ctejada10/echotube/assets/media/bike.jpg

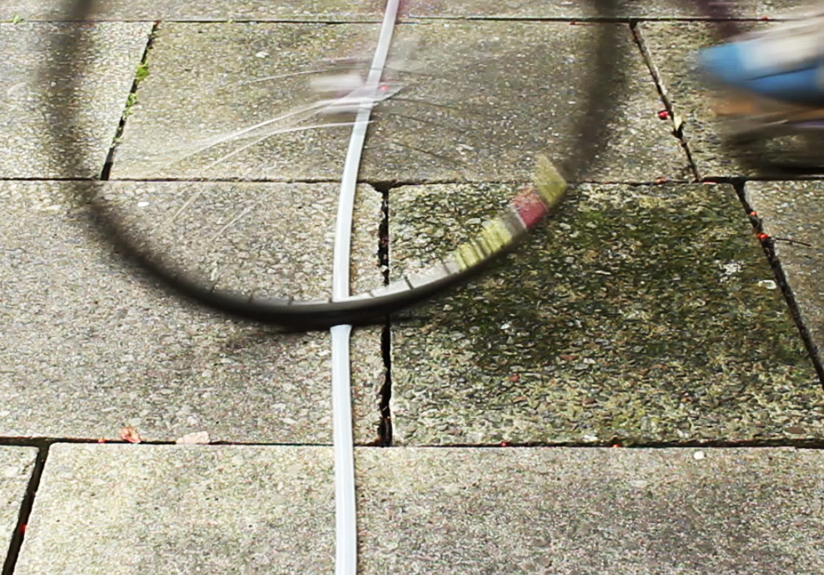
assets/media/bike.jpg
