ctejada10/echotube/assets/media/biketracker.jpg

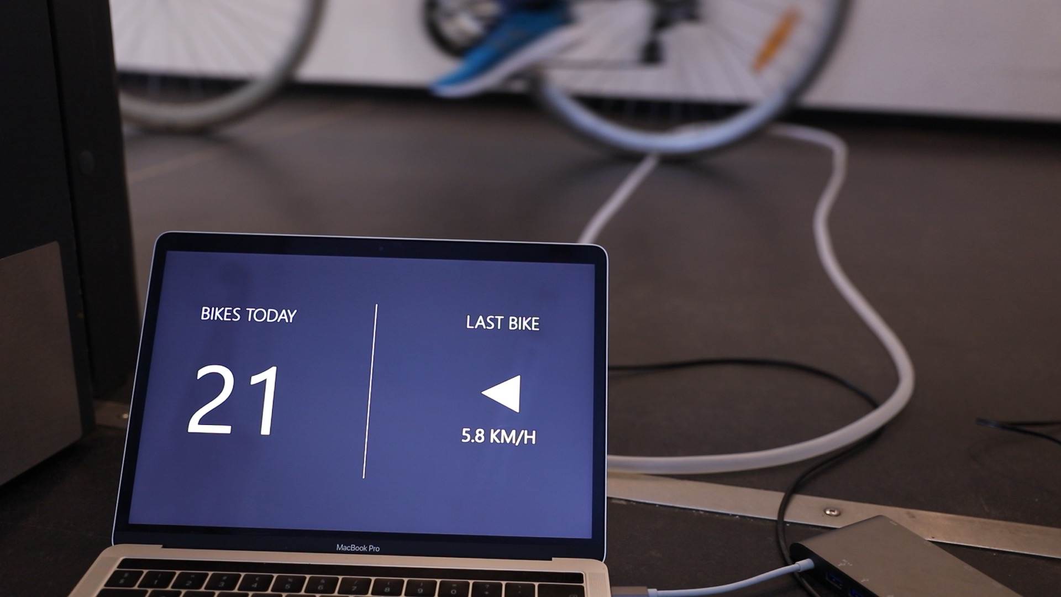
assets/media/biketracker.jpg
