ctejada10/echotube/assets/media/coupling.jpg

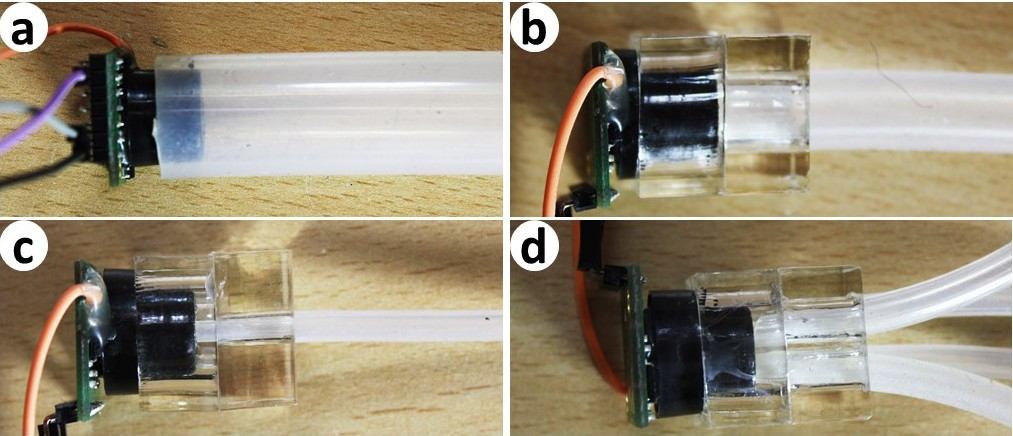
assets/media/coupling.jpg
