ctejada10/echotube/assets/media/dual_touch.png

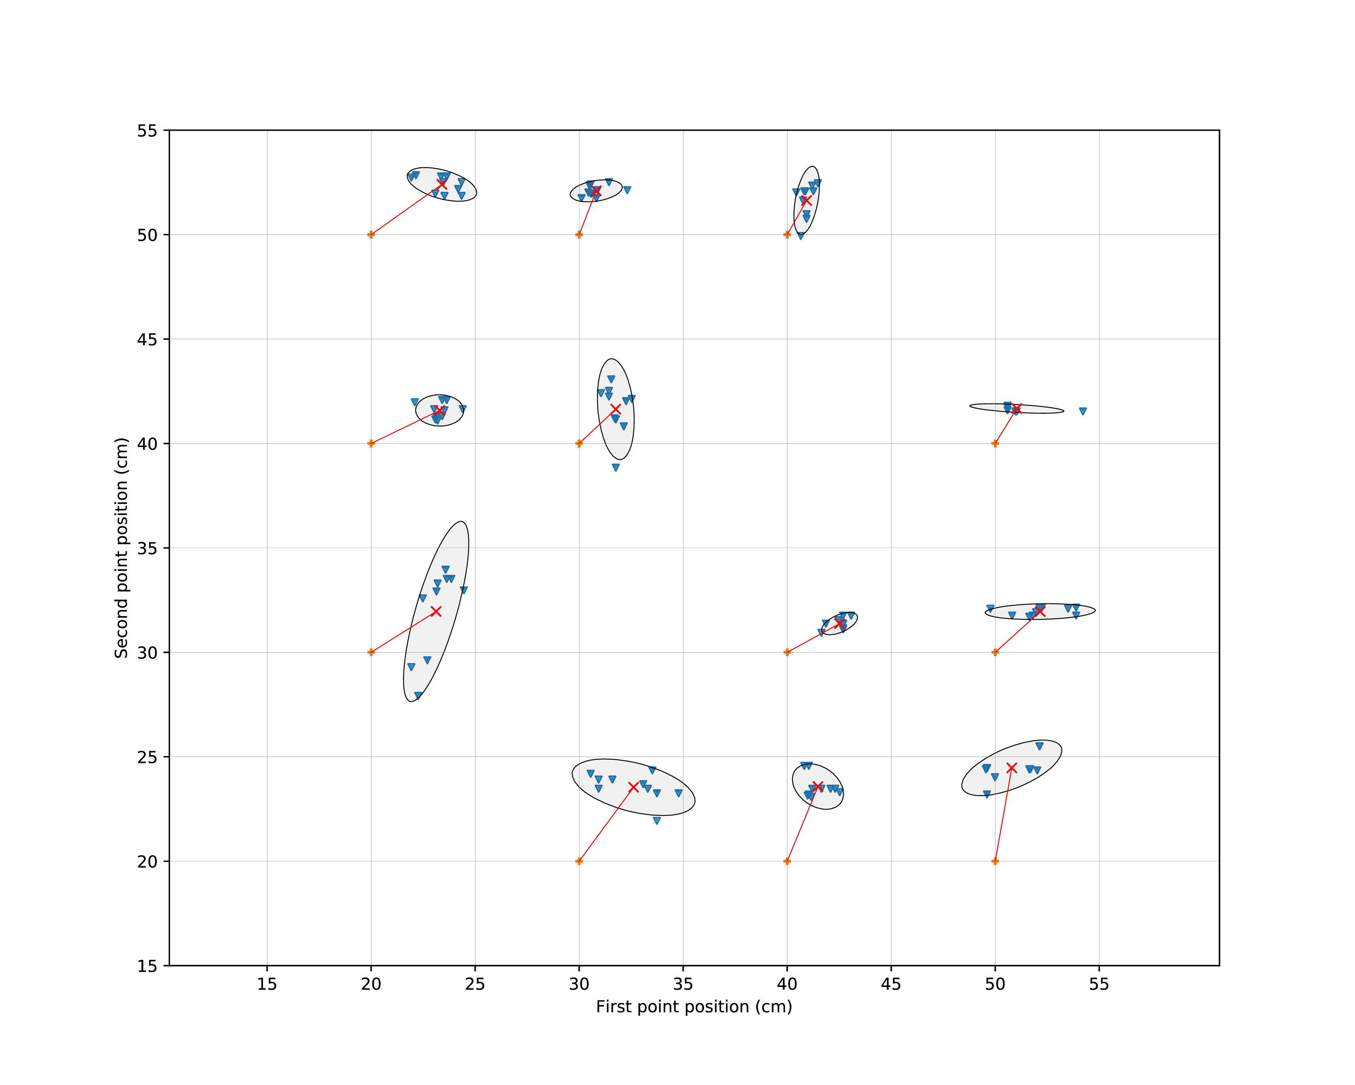
assets/media/dual_touch.png
