ctejada10/echotube/assets/media/error.png

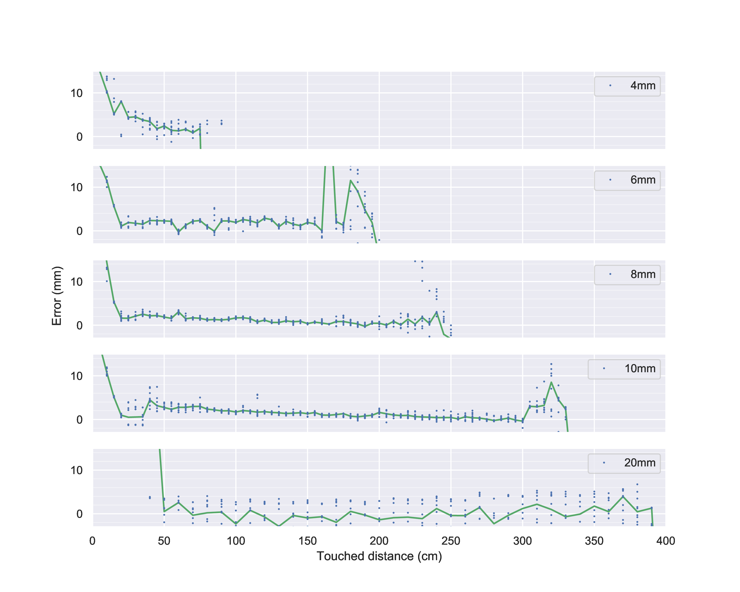
assets/media/error.png
