ctejada10/echotube/assets/media/glove.jpg

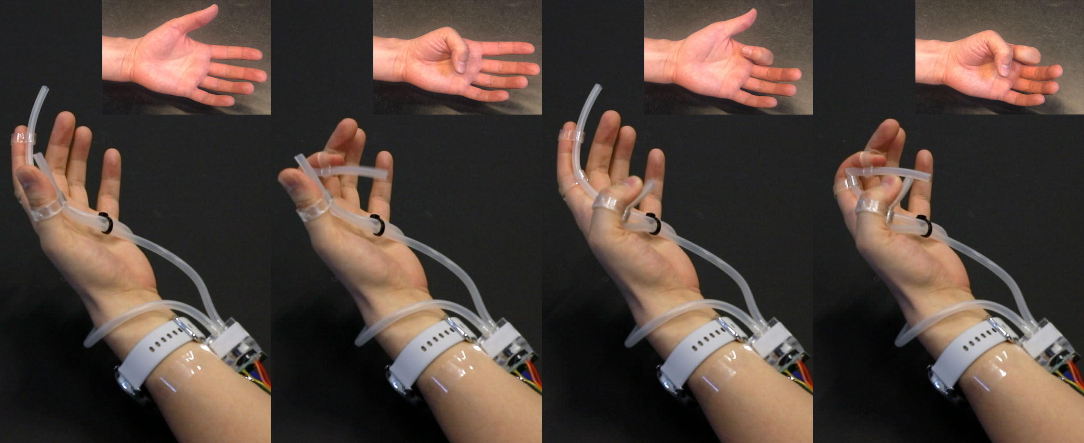
assets/media/glove.jpg
