ctejada10/echotube/assets/media/modular.jpg

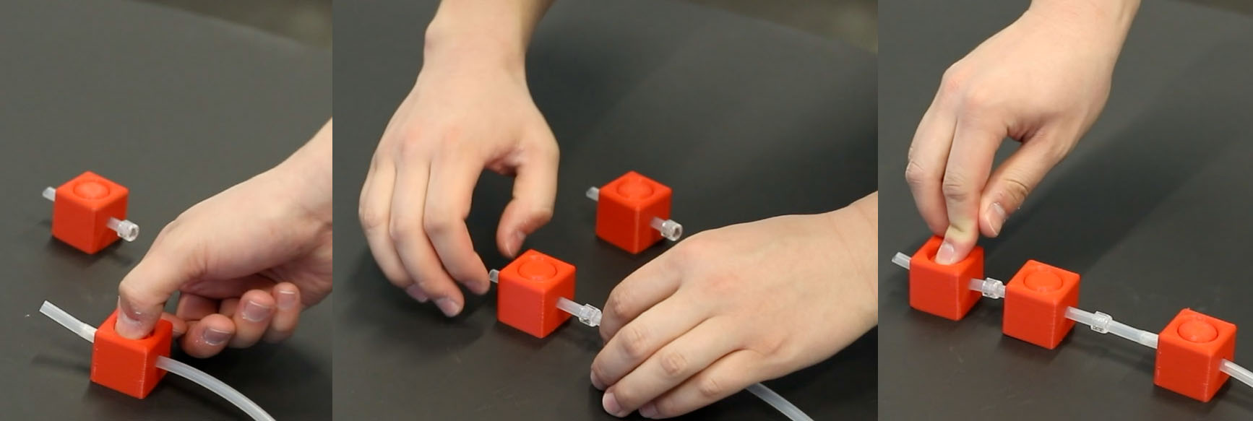
assets/media/modular.jpg
