ctejada10/echotube/assets/media/peak_detection.png

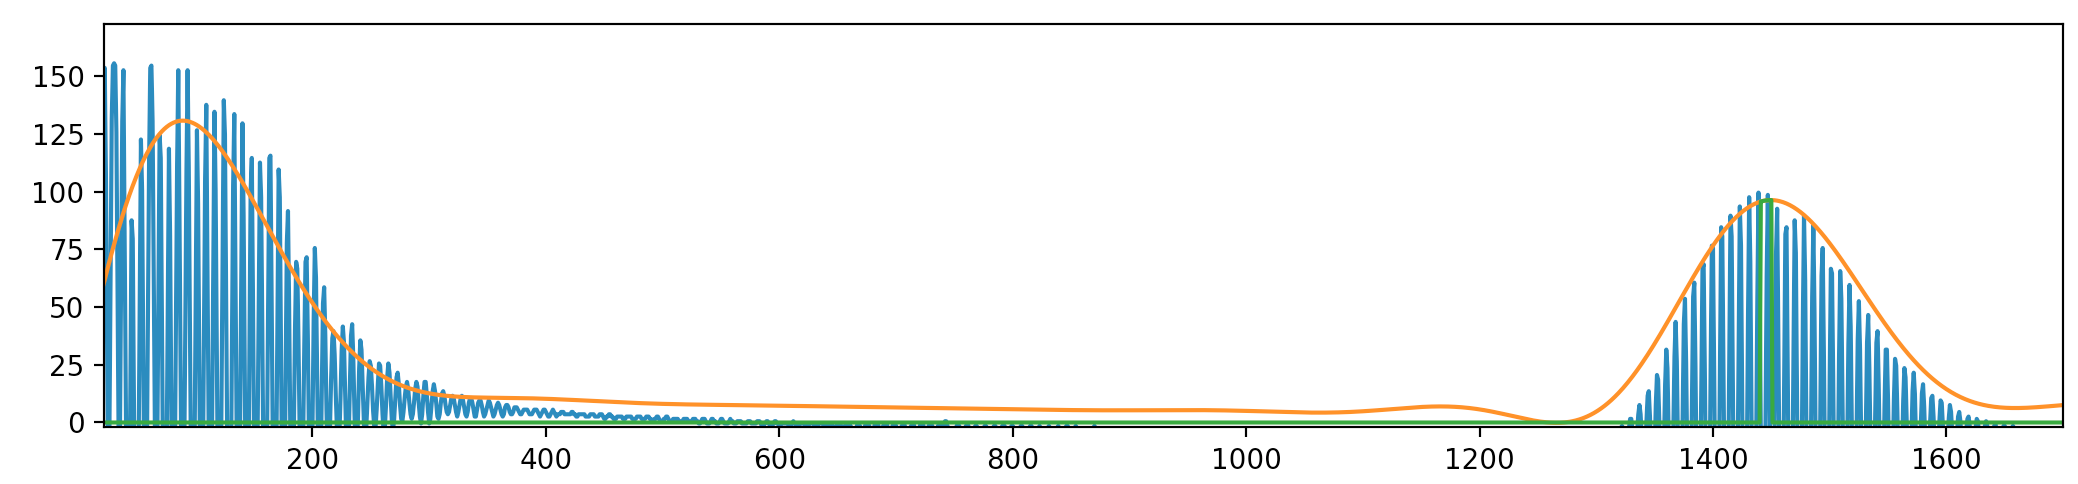
assets/media/peak_detection.png
