ctejada10/echotube/assets/media/sink.jpg

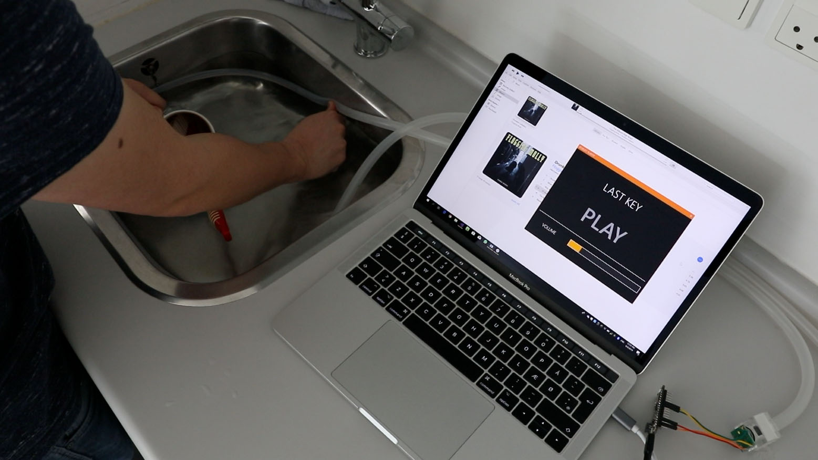
assets/media/sink.jpg
