ctejada10/echotube/assets/media/spiral_tube.jpg

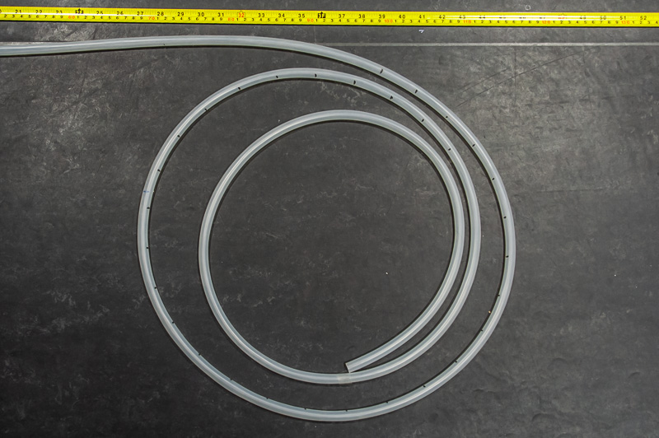
assets/media/spiral_tube.jpg
