ctejada10/echotube/assets/media/straight_curved.png

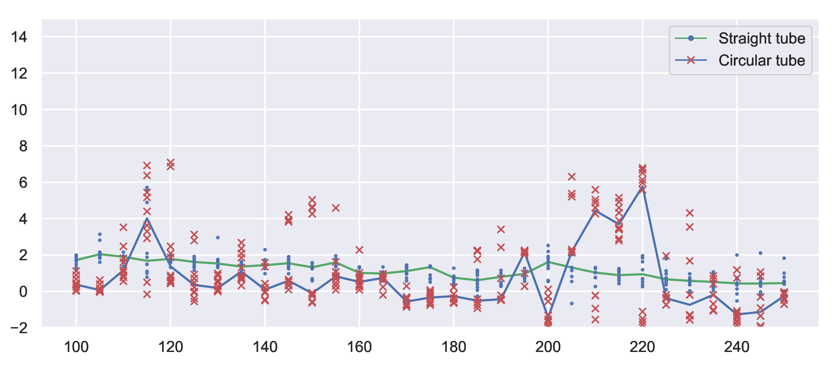
assets/media/straight_curved.png
