ctejada10/echotube/assets/media/transducer.png

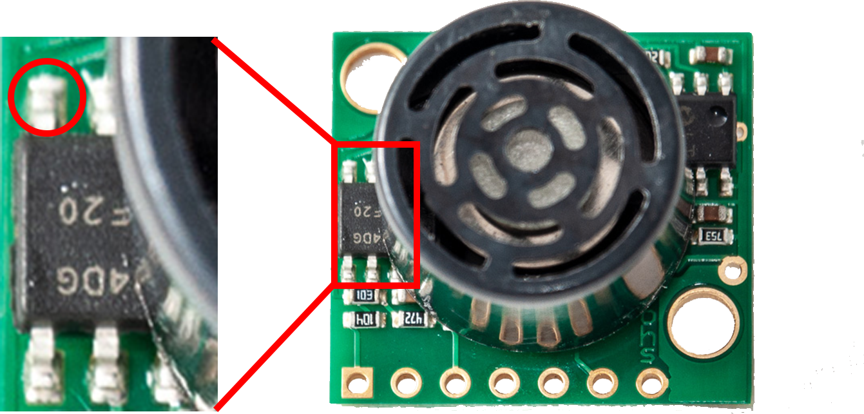
assets/media/transducer.png
