ctejada10/echotube/assets/media/setup.jpg

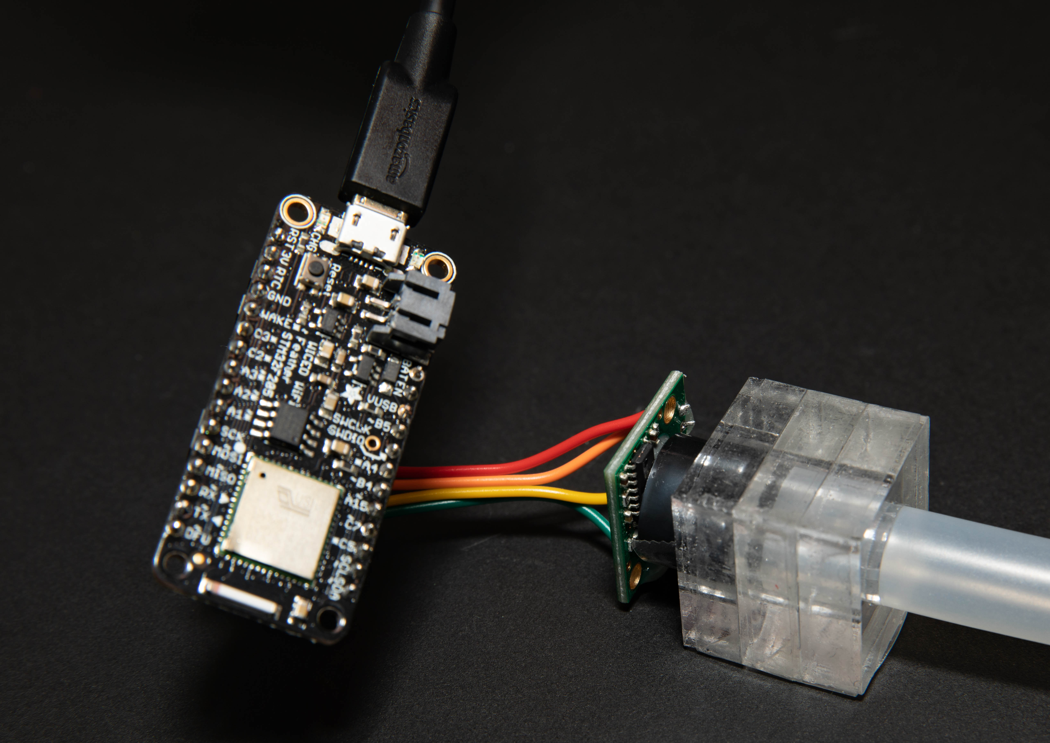
assets/media/setup.jpg
